jeromeverhoeven/firefly_jar/README.md

# 0xd
Define-Design-Develop-Destroy-Deploy

Structure of repository for product development

# Define:  The definition of the product
| Deliverable | Description | Owner |
|----|----|-----|
| [6080001](./Define/6080001.md)| MuSCoW |Jerome Verhoeven|

# Design: The design of the product
| Deliverable | Description | Owner |
|----|----|-----|
| [6080002](./Design/6080002.md) | Design Specification (Spec-2 Rev C) and House of Quality | Jerome Verhoeven|
| [6080003](./Design/6080003.md) | DD-1: Triggering Mechanism(s) | Jerome Verhoeven|
| [6080004](./Design/6080004.md) | DD-2: Electronics Platform | Jerome Verhoeven|
| [6080005](./Design/6080005.md) | DD-3: Power Source | Jerome Verhoeven|
| [6080006](./Design/6080006.md) | DD-4: LED Type and Count | Jerome Verhoeven|
| [6080007](./Design/6080007.md) | DD-5: Glow-Cycle Timing | Jerome Verhoeven|
| [6080008](./Design/6080008.md) | DD-6: Lid Venting | Jerome Verhoeven|
| [6080009](./Design/6080009.md) | DD-7: LED Mounting and Electronics Location | Jerome Verhoeven|
| [6080010](./Design/6080010.md) | DD-8: LED Color | Jerome Verhoeven|
| [6080011](./Design/6080011.md) | DD-9: Glow Pattern and Modes | Jerome Verhoeven|
| [6080012](./Design/6080012.md) | DD-10: Enclosure | Jerome Verhoeven|
| [Design Specification Template](./Design/Spec-1.md) | Template | TBD|
| [Design Decision Template](./Design/decision-template.md) | Template | TBD|

# Develop: The development of the product
| Deliverable | Description | Owner |
|----|----|----|
| [6080013](./Develop/6080013.md) | Bill of Materials | Jerome Verhoeven|
| [6080014](./Develop/6080014.md) | Flash Pattern Simulator ("Big Dipper Dialogue") | Jerome Verhoeven|
| [6080015](./Develop/6080015.md) | Dev Note: Courtship Sequence (male J-flash, female answer) | Jerome Verhoeven|
| [6080016](./Develop/6080016.md) | Prototype Assembly Drawings | Jerome Verhoeven|
| [6080017](./Develop/6080017.md) | Prototype Test Firmware | Jerome Verhoeven|
| [Asset Template](./Develop/asset-template.md) | Template | TBD|
| [Sample Asset](./Develop/sample1.md) | Template | TBD|

# Destroy: Testing
## Test Cases: Test Procedures
|Deliverable | Owner |
|----|----|
| [TC-EXAMPLE](./Destroy/TestCases/TC-EXAMPLE.md) | TBD |

## TestCycle-1
|[TC-EXAMPLE-EXE](./Destroy/TestCycle-1/TC-EXAMPLE-EXE.md) | Result |

# Deploy
| Deliverable | Description | Owner |
|---|---|---|
| [Asset Template](./Deploy/asset-template.md) | Description of Asset | TBD |

# Appendix
| File | Description | Owner |
|---|---|---|
| [Datasheets](./Appendix/Datasheets/README.md) | Manufacturer datasheets for BOM electronic parts | Jerome Verhoeven |
| [Asset Template](./Appendix/asset-template.md) | Description of Asset | TBD |
