jeromeverhoeven/firefly_jar/Design/6080002.md

# Asset: 6080002

## Description
Design specification for the Firefly Jar: renderings, functional and non-functional requirements traced to MuSCoW, architecture, pin map, behavior state machine, bill of materials and cost assessment, firmware configuration, assembly procedure, test plan, deployment schedule, rollback plan, and the House of Quality. Each design decision is its own asset (6080003-6080012).

## Revision
- A: initial working version
- B: all open design decisions resolved; House of Quality added; cost and operating principle updated
- C: specification restructured to the Spec-1 template; renderings redrawn for the top-hung lid layout; lid disc layout drawing, pin map, firmware parameters, assembly steps, test plan, and schedule added

## Content
 - [Design Specification](./Spec-2.md)
 - [House of Quality](./House-of-Quality.md)
 - [Exterior rendering](./Spec-2-media/rendering-exterior.svg)
 - [Internal section rendering](./Spec-2-media/rendering-internal-section.svg)
 - [Lid disc layout](./Spec-2-media/lid-disc-layout.svg)
 - Design decision assets: [6080003](./6080003.md), [6080004](./6080004.md), [6080005](./6080005.md), [6080006](./6080006.md), [6080007](./6080007.md), [6080008](./6080008.md), [6080009](./6080009.md), [6080010](./6080010.md), [6080011](./6080011.md), [6080012](./6080012.md)
