jeromeverhoeven/firefly_jar/Design/6080003.md

# Asset: 6080003

## Description
DD-1: Triggering Mechanism(s). Design decision selecting the wake/trigger sensors and how they combine: LDR (dusk) OR accelerometer (tap/shake/tilt) on the XIAO Sense, with the microphone as an opt-in clap mode. Includes standby-current analysis and the forced-rank options table.

## Revision
- A: initial decision (tilt/vibration switch + LDR, OR'd, ATtiny platform)
- B: re-evaluated against MuSCoW items 14-24 and DD-2 platform; accelerometer replaces tilt switch; sleep-current risk added

## Content
 - [DD-1: Triggering Mechanism(s)](./DD-1-Trigger-Mechanism.md)
