jeromeverhoeven/firefly_jar/Design/6080004.md

# Asset: 6080004

## Description
DD-2: Electronics Platform. Design decision selecting the MCU/board: Seeed XIAO nRF52840 Sense, chosen over ATtiny85 discrete builds, plain XIAO, and QT Py + BFF. Covers cost against the item 3 rule, build time, charging, reprogramming (item 22), and spare I/O.

## Revision
- A: initial working version

## Content
 - [DD-2: Electronics Platform](./DD-2-Platform.md)
