jeromeverhoeven/firefly_jar/Design/6080005.md

# Asset: 6080005

## Description
DD-3: Power Source. Design decision selecting a 500 mAh protected LiPo charged through the XIAO's USB-C charger. Contains the reference use profile and battery model used by every design decision's battery-life column.

## Revision
- A: initial working version

## Content
 - [DD-3: Power Source](./DD-3-Power-Source.md)
