jeromeverhoeven/firefly_jar/Design/6080006.md

# Asset: 6080006

## Description
DD-4: LED Type and Count. Design decision selecting 6 pre-wired 0603 3 V LEDs per jar (swarm density, joints, pins, battery impact).

## Revision
- A: initial working version

## Content
 - [DD-4: LED Type and Count](./DD-4-LED-Type-and-Count.md)
