jeromeverhoeven/firefly_jar/Design/6080007.md

# Asset: 6080007

## Description
DD-5: Glow-Cycle Timing and Wake Behavior. Design decision defining the night-light and toy timing: 30-minute night show with settle-down and re-arm rule; 60 s toy shows stackable to 5 minutes. Includes the behavior state machine.

## Revision
- A: initial working version

## Content
 - [DD-5: Glow-Cycle Timing and Wake Behavior](./DD-5-Glow-Cycle.md)
