jeromeverhoeven/firefly_jar/Design/6080008.md

# Asset: 6080008

## Description
DD-6: Lid Venting. Design decision for lid venting: 5-7 small "air holes" in the lid disc and dry preserved moss only (heat, condensation, mic, and thematic analysis).

## Revision
- A: initial working version

## Content
 - [DD-6: Lid Venting](./DD-6-Lid-Vent.md)
