jeromeverhoeven/firefly_jar/Design/6080009.md

# Asset: 6080009

## Description
DD-7: LED Mounting and Electronics Location. Design decision moving all electronics to a custom lid disc with the USB-C port facing up and LEDs hanging on loop-through anchors (top-hung vs. bottom-up).

## Revision
- A: initial working version

## Content
 - [DD-7: LED Mounting and Electronics Location](./DD-7-LED-Stem-Mounting.md)
