jeromeverhoeven/firefly_jar/Design/6080010.md

# Asset: 6080010

## Description
DD-8: LED Color. Design decision selecting yellow pre-wired LEDs as the standard firefly color, with warm white optional per cousin.

## Revision
- A: initial working version

## Content
 - [DD-8: LED Color](./DD-8-LED-Color.md)
