jeromeverhoeven/firefly_jar/Design/6080011.md

# Asset: 6080011

## Description
DD-9: Glow Pattern and Modes. Design decision for the animation: firefly-cadence fades with call-and-response, double-tap modes (Meadow → Sync → Clap), settle-down, low-battery, and tilt cues, with tiered firmware scope.

## Revision
- A: initial working version

## Content
 - [DD-9: Glow Pattern and Modes](./DD-9-Glow-Pattern.md)
