jeromeverhoeven/firefly_jar/Design/6080012.md

# Asset: 6080012

## Description
DD-10: Enclosure. Design decision for the jar: shatter-resistant PET for cousins 12 and under, glass for 13-16, sharing one lid design.

## Revision
- A: initial working version

## Content
 - [DD-10: Enclosure](./DD-10-Enclosure.md)
