jeromeverhoeven/firefly_jar/Develop/6080016.md

# Asset: 6080016

## Description
Prototype assembly drawings: a new wiring diagram (XIAO pins to LEDs, LDR divider, and battery — the one visual the project didn't have yet, since the pin map was table-only), plus a prototype-specific build checklist layered on top of [Spec-2's text assembly procedure](../Design/Spec-2.md#assembly-procedure-per-jar) and the existing [lid disc layout](../Design/Spec-2-media/lid-disc-layout.svg). Documents and resolves the as-purchased LED's built-in resistor (differs from [DD-4](../Design/DD-4-LED-Type-and-Count.md)'s bare-LED spec, flagged in the [2026-10-10 meeting](./Meetings/2026-10-10-Prototype-Parts-Order.md)).

## Revision
- A: initial build — wiring diagram, built-in-resistor resolution, prototype build checklist.
- B: corrected battery pads from assumed BAT+/BAT− to the actual silkscreened VIN/GND (found by inspecting the physical board); confirmed via the Seeed schematic that the USB-C shell shares the same GND net; added the ground-bus hand-soldering technique and the XIAO "on edge" mounting technique.

## Content
- [Assembly drawings and build checklist](./Assembly.md)
- [Wiring diagram](./Assembly-media/wiring-diagram.svg)
