jeromeverhoeven/firefly_jar/Develop/6080013.md

# Asset: 6080013

## Description
Bill of Materials for the Firefly Jar: every part needed to build one unit, with vendor, manufacturer, part numbers, and cost at qty 1 and qty 10, traced to the [Design Specification](../Design/Spec-2.md) and its design decisions (DD-1 through DD-10). Manufacturer datasheets for the electronic parts are collected in [Appendix/Datasheets](../Appendix/Datasheets/).

## Revision
- A: initial BOM, Develop-phase sourcing pass
- B: U1 vendor corrected from Seeed direct to Mouser, per the [2026-10-10 dev meeting](./Meetings/2026-10-10-Prototype-Parts-Order.md) — Seeed's own store was out of stock (per [DD-2](../Design/DD-2-Platform.md)), Mouser is the stock-driven choice DD-2 actually recommends

## Content
- [Bill of Materials](./BOM.md)
