jeromeverhoeven/firefly_jar/Develop/sample1.md

# Asset: sample1

## Description
A company called digikey

## Revision
unknown

## Content
- [www.digikey.com](http://www.digikey.com)
