jeromeverhoeven/firefly_jar/Design/Spec-1.md

# Design Specification

## Project Overview
Provide a brief overview of the project, including its purpose, goals, and objectives.
Just a generic link to an image generic

## Requirements
### Functional Requirements
List and describe the functional requirements of the project.

### Non-Functional Requirements
List and describe the non-functional requirements of the project.

## Design
### Architecture
Describe the overall architecture of the project, including diagrams if necessary.

```mermaid
classDiagram
        Animal <|-- Duck
        Animal <|-- Fish
        Animal <|-- Zebra
        Animal : +int age
        Animal : +String gender
        Animal: +isMammal()
        Animal: +mate()
        class Duck {
          +String beakColor
          +swim()
          +quack()
        }
        class Fish {
          -int sizeInFeet
          -canEat()
        }
        class Zebra {
          +bool is_wild
          +run()
        }
```

### Flow Chart Template
```mermaid
flowchart TD
        A(["Start"])
        A --> B{"Decision"}
        B --> C["Option A"]
        B --> D["Option B"]
```
### Sequence Diagram Template
```mermaid
sequenceDiagram
        actor Alice
        actor Bob
        Alice->>Bob: Hi Bob
        Bob->>Alice: Hi Alice
```

### Components
List and describe the main components of the project.

### Data Model
Provide a data model for the project, including diagrams if necessary.

## Implementation
### Technologies
List and describe the technologies that will be used in the project.

### Tools
List and describe the tools that will be used in the project.

## Testing
### Test Plan
Describe the test plan for the project, including the types of tests that will be performed.

### Test Cases
List and describe the test cases for the project.

## Deployment
### Deployment Plan
Describe the deployment plan for the project, including the environments and steps required.

### Rollback Plan
Describe the rollback plan in case of deployment failure.

## Maintenance
### Monitoring
Describe how the project will be monitored after deployment.

### Updates
Describe the process for updating the project after deployment.

## Appendix
Include any additional information or references here.
