jeromeverhoeven/firefly_jar/Develop/BOM.md

# Bill of Materials — Firefly Jar

**Asset:** [6080013](./6080013.md) · Traces to [Spec-2 Components](../Design/Spec-2.md#components) and the [Design Decisions](../Design/Spec-2.md#design-decisions) (DD-1 through DD-10). Datasheets for the electronic parts are in [Appendix/Datasheets](../Appendix/Datasheets/).

Qty is per jar unless marked "shared" (a consumable or bulk pack split across all 12 units). Cost columns are the vendor's own per-unit price at that purchase quantity, not an allocation of a shared pack — see **Sourcing notes** below for how bulk-only items (LEDs, jars, sheet goods) translate into a per-jar cost.

| # | Ref | Qty | Description | Vendor | Vendor P/N | Manufacturer | Mfr P/N | Cost @ Qty 1 | Cost @ Qty 10 | Link to Item |
|---|---|---|---|---|---|---|---|---|---|---|
| 1 | U1 | 1 | MCU module: nRF52840 (Cortex-M4F), onboard LSM6DS3TR-C 6-axis IMU, PDM mic, BQ25101 LiPo charger, USB-C | Mouser | [713-102010469](https://www.mouser.com/ProductDetail/Seeed-Studio/102010469) | Seeed Studio | 102010469 | $15.90 | not confirmed — check live Mouser price-break table before ordering | [Mouser](https://www.mouser.com/ProductDetail/Seeed-Studio/102010469) |
| 2 | BT1 | 1 | LiPo battery, 3.7 V 500 mAh, protected, pre-attached JST-PH connector | Adafruit | [1578](https://www.adafruit.com/product/1578) | Adafruit (cell form factor LP503035) | LP503035 | $7.95 | $7.16 (10+) | [Adafruit #1578](https://www.adafruit.com/product/1578) |
| 3 | J1 | 1 | JST-PH 2-pin cable, male header, 200 mm leads (pigtail soldered to XIAO BAT pads) | Adafruit | [3814](https://www.adafruit.com/product/3814) | Adafruit | 3814 | $0.75 | $0.68 (10-99) | [Adafruit #3814](https://www.adafruit.com/product/3814) |
| 4 | LDR1 | 1 | CdS photoresistor (LDR), GL5528-class, 5 mm | Adafruit | [161](https://www.adafruit.com/product/161) | Generic (GL5528) | GL5528 | $0.95 | $0.95 (flat) | [Adafruit #161](https://www.adafruit.com/product/161) |
| 5 | R7 | 1 | 100 kΩ 1/4 W carbon-film resistor, LDR pull-down divider | DigiKey | [CFR-25JB-52-100K](https://www.digikey.com/en/products/detail/yageo/CFR-25JB-52-100K/245) | YAGEO | CFR-25JB-52-100K | ~$0.10 (est.) | $0.034 (10+) | [DigiKey](https://www.digikey.com/en/products/detail/yageo/CFR-25JB-52-100K/245) |
| 6 | R1-R6 | 6 | 1 kΩ 1/4 W carbon-film resistor, LED series resistor on D2-D7 | DigiKey | [CFR-25JB-52-1K](https://www.digikey.com/en/products/detail/yageo/CFR-25JB-52-1K/96) | YAGEO | CFR-25JB-52-1K | ~$0.10 (est.) ea. | ~$0.034 (est., 10+) ea. | [DigiKey](https://www.digikey.com/en/products/detail/yageo/CFR-25JB-52-1K/96) |
| 7 | D1-D6 | 6 | Pre-wired 0603 SMD LED, yellow, 3 V (no onboard resistor), 30 cm leads | eBay (listing 227363613241) | — (no catalog P/N; seller listing only) | Unbranded / generic OEM | — | n/a — bulk only | $29.99 per 100-pack + ~$3 ship (≈$0.33/LED) | [eBay listing](https://www.ebay.com/itm/227363613241) |
| 8 | — | 1 (PET-assigned jars) | 16 oz clear PET plastic mason-style jar w/ lid, regular-mouth thread (**verify band fit before bulk order**, per [DD-10](../Design/DD-10-Enclosure.md)) | Amazon | [B07WVRF2XV](https://www.amazon.com/Clear-Plastic-Labels-Kitchen-ZMYBCPACK/dp/B07WVRF2XV) | ZMYBCPACK | — | n/a — 12-pack only | ≈$2.25/jar (12-pack; est., see note) | [Amazon listing](https://www.amazon.com/Clear-Plastic-Labels-Kitchen-ZMYBCPACK/dp/B07WVRF2XV) |
| 9 | — | 1 (glass-assigned jars) | 16 oz Ball regular-mouth glass pint mason jar w/ lid & band | HEB | [30016](https://www.heb.com/product-detail/ball-regular-mouth-12-pk-pint-mason-jars-lids/30016) | Ball (Newell Brands) | 14400-61000 | n/a — 12-pack only | $1.12/jar (12-pack, $13.44 total) | [HEB listing](https://www.heb.com/product-detail/ball-regular-mouth-12-pk-pint-mason-jars-lids/30016) |
| 10 | — | ~1/12 sheet | 3 mm Baltic birch plywood, 12x12 in, cut to the jar's lid-insert diameter for the custom disc ([DD-7](../Design/DD-7-LED-Stem-Mounting.md)) | Amazon | [B07H3CGLQ8](https://www.amazon.com/Artlicious-3mm-Baltic-Plywood-Sheets/dp/B07H3CGLQ8) | Artlicious | — | n/a — 20-pack only | $1.70/sheet (20-pack, $33.99 total) | [Amazon listing](https://www.amazon.com/Artlicious-3mm-Baltic-Plywood-Sheets/dp/B07H3CGLQ8) |
| 11 | — | 1 sheet | Translucent/frosted vellum sheet, 12x12 in, jar liner for a consistent diffused glow ([DD-10](../Design/DD-10-Enclosure.md)) | Amazon | [B08BNR9WG9](https://www.amazon.com/Translucent-Vellum-Paper-Sheets-Invitations/dp/B08BNR9WG9) | Generic/craft | — | n/a — 100-pack only | $0.23/sheet (100-pack, $22.99 total) | [Amazon listing](https://www.amazon.com/Translucent-Vellum-Paper-Sheets-Invitations/dp/B08BNR9WG9) |
| 12 | — | shared (1 bag / 12 units) | Preserved (dry) reindeer moss, base dressing — dry only, no live moss ([DD-6](../Design/DD-6-Lid-Vent.md)) | Amazon | [B07QSD64QB](https://www.amazon.com/Preserved-Reindeer-Moss-oz-Spanish/dp/B07QSD64QB) | Generic/SuperMoss-style | — | $6.99 (2 oz bag, shared) | n/a — single bag covers all 12 | [Amazon listing](https://www.amazon.com/Preserved-Reindeer-Moss-oz-Spanish/dp/B07QSD64QB) |
| 13 | — | shared | Mini hot-glue sticks, 4 in x 0.27 in, clear all-temp — LED anchor strain relief, moss/liner mounting | Amazon | [B003JZII34](https://www.amazon.com/Surebonder-DT-100-Sticks-All-Temperature-5-Sticks-100/dp/B003JZII34) | Surebonder | DT-100 | $5.67 (100-pack, shared) | n/a — single pack covers all 12 | [Amazon listing](https://www.amazon.com/Surebonder-DT-100-Sticks-All-Temperature-5-Sticks-100/dp/B003JZII34) |
| 14 | — | shared | 22 AWG stranded silicone hookup wire, 6-color kit — BAT pigtail extension, anchor-loop leads | Amazon | [B01LH1FR6M](https://www.amazon.com/StrivedayTMFlexible-Silicone-Electric-electronic-electrics/dp/B01LH1FR6M) | Striveday | — | $14.99 (kit, shared) | n/a — single kit covers all 12 | [Amazon listing](https://www.amazon.com/StrivedayTMFlexible-Silicone-Electric-electronic-electrics/dp/B01LH1FR6M) |
| 15 | — | optional, 1/gift | USB-C charging cable — **optional add-on, not required** (most households already own one); excluded from the unit-cost total per [Spec-2 Cost Feasibility](../Design/Spec-2.md#cost-feasibility) | Amazon (generic) | — | Generic | — | ~$6-8 (est., per cable) | n/a | — |

## Sourcing notes
- **U1 vendor corrected to Mouser (2026-10-10 dev meeting).** Seeed's own store was out of stock as of Oct 9, 2026 per [DD-2](../Design/DD-2-Platform.md)'s own Availability research; Mouser (713-102010469, ~391 in stock at the time of DD-2) is the stock-driven choice DD-2 actually recommends, so the BOM now matches it instead of citing Seeed direct for cleaner qty-10 pricing. Mouser's qty-10 price break wasn't independently confirmed in this pass — check the live pricing table before ordering.
- **LEDs, jars, and sheet goods are bulk-only.** The eBay LED listing, both jar vendors, the plywood, and the vellum are sold only in fixed packs (100, 12, 12, 20, and 100 respectively) — there is no distributor "qty 1" or "qty 10" price break to quote, so the Cost columns show the pack price and the effective per-item cost it works out to.
- **R7 and R1-R6 pricing is an estimate** (marked "est."): DigiKey's own qty-10 break for this exact YAGEO CFR-25 value wasn't confirmed by automated search in this pass — confirm the live price on the DigiKey product pages linked above before ordering.
- **PET jar vendor is a substitute**, not the one named in [DD-10](../Design/DD-10-Enclosure.md) — the Cornucopia 16 oz 8-pack DD-10 names was out of stock as of Oct 9, 2026. This ZMYBCPACK 12-pack is a same-category replacement found during this BOM pass. **Per DD-10's own open item, test-fit one jar's thread against the regular-mouth lid disc/band before ordering the rest.**
- **Jar split:** DD-10 assumes a 6/6 PET-vs-glass split pending the actual cousin age count — order rows 8 and 9 in that ratio until the age split (an [open item](../Design/Spec-2.md#open-items) in Spec-2) is confirmed.
- **Shared consumables** (moss, glue, wire kit, and the fractional plywood/vellum sheets) are bought once and divided across all 12 units by hand during assembly — their Qty column says "shared" rather than a per-jar count.
- **Spares:** order the 100-pack of LEDs even though only 72 are needed (6 x 12) — this already includes 28 spares per [DD-4](../Design/DD-4-LED-Type-and-Count.md). No other line needs a separate spares order at this batch size.

## Per-jar cost rollup (qty-1 columns, electronics only)
U1 + BT1 + J1 + LDR1 + R7 + 6xR1-R6 + 6xD1-D6 = $15.90 + $7.95 + $0.75 + $0.95 + $0.10 + $0.60 + $1.98 ≈ **$24.23/unit** in electronics, close to the [Spec-2](../Design/Spec-2.md#cost-feasibility) Rev C estimate of ~$29.99/unit once the jar, lid disc, liner, and dressing (rows 8-13) are added. Small differences from Spec-2's figures reflect this pass's actual vendor sourcing (e.g., Seeed direct vs. Mouser, and a substitute PET jar vendor) rather than a design change.
