jeromeverhoeven/firefly_jar/Destroy/TestCases/TC-PCBA-BOM-COMP-SUB.md

## Test ID:
TC-PCBA-BOM-COMP-SUB

## Test Name:
PCBA BOM Component Substitution — General Procedure

## Test Description:
Verify that a proposed substitute component is acceptable for use on the PCBA by validating electrical, mechanical, and procurement attributes, performing assembly/prototype verification, and executing basic functional and thermal tests.

## Scope:
Applies to one proposed substitute component on the PCBA BOM. This is a general procedure; specific test limits and measurements depend on the component type and circuit function.

## Preconditions:
- Original BOM and proposed substitute BOM entry available.
- Datasheets for original and substitute components.
- Board layout / footprint drawings.
- One or more sample substitute components available.
- Rework station or assembly capability to populate at least one board.

## Result:
- Result of the test execution

## Test Steps:
| Step Number | Description | Test Data / Artifacts | Expected Results / Pass Criteria | Link | Actual Results | Notes |
|---|---|---|---|---|---|---|
| 1 | Review BOM and part history | BOM, ECOs, procurement records | Identify original part number and proposed substitute | [BOM](#) | | Confirm revision levels |
| 2 | Compare datasheets: electrical specs | Datasheets (original + substitute) | Key parameters (voltage, current, tolerance, ESR, etc.) are equal or within acceptable delta | [DS](#) | | Document any differences |
| 3 | Verify mechanical/footprint and pinout compatibility | Footprint drawings, 3D models | Substitute fits footprint; pin mapping matches | [Footprint](#) | | Note adapter or landing changes |
| 4 | Check reliability / environmental ratings | Datasheets, reliability reports | Temperature, moisture, shock ratings meet requirements  | [Env](#) | | |
| 5 | Confirm procurement, lead-time, cost, and manufacturer qualification | Supplier quotes, MOQ, QPL/approval status | Supplier viable; cost/lead-time acceptable | [PO](#) | | |
| 6 | Create or update BOM entry and cross-reference (internal part numbers) | Updated BOM, change record | BOM updated with justification and traceability | [BOM-Change](#) | | Include approval fields |
| 7 | Populate prototype or perform controlled rework on one or more boards | Reworked board(s), assembly report | Component correctly soldered with no mechanical issues  | [Assembly](#) | | Use same process as production |
| 8 | Visual inspection and microscopy | Inspection report, photos | No solder bridges, tombstoning, or misalignment | [Inspect](#) | | |
| 9 | Basic electrical checks (continuity, shorts, passive measurements) | DMM, LCR meter | No shorts; expected passive values within tolerance | [Elec](#) | | Test critical nets |
| 10 | Power-up with current limit and smoke test | Bench PSU, current limit | Board powers without overcurrent or smoke | [Power](#) | | Monitor temperature |
| 11 | Functional verification of affected circuit blocks | Functional test vectors, test jig | Circuit meets functional requirements | [Func](#) | | Run regression tests |
| 12 | Thermal and stress check under expected load | Thermal camera, temperature sensors | Temperatures within allowed range, no degradation | [Thermal](#) | | Duration per spec |
| 13 | Record results, attach evidence, and obtain engineering sign-off | Test reports, photos, datasheet comparison | Formal approval or rejection with defined remediation | [Report](#) | | Include recommended actions  |
| 14 | If approved, publish BOM revision and notify manufacturing | Approved ECO, updated BOM | Production BOM updated; supplier notified | [ECO](#) | | Close change loop |
