jeromeverhoeven/firefly_jar/Destroy/TestCases/TC-EXAMPLE.md

## Test ID:
TC-EXAMPLE

## Test Name:
Example Test Case

## Test Description:
Example Description

## Test Steps:
| Step Number | Description | Test Data | Expected Results | Link |
|---|---|---|---|---|
| 1 | Description of step 1  | Test data 1 | Expected result for step 1 | [Link 1](#) |
| 2 | Description of step 2  | Test data 2 | Expected result for step 2 | [Link 2](#) |
| 3 | Description of step 3  | Test data 3 | Expected result for step 3 | [Link 3](#) |
