jeromeverhoeven/firefly_jar/Destroy/TestCycle-1/TC-EXAMPLE-EXE.md

## Test ID:
TC-EXAMPLE

## Test Name:
Example Test Case

## Test Description:
Example Description

## Result:
- Result of the test execution
## Test Steps:
| Step Number | Description | Test Data | Expected Results | Link | Actual Results | Pass / Fail | Results Link | Notes |
|---|---|---|---|---|---|---|---|---|
| 1 | Description of step 1  | Test data 1 | Expected result for step 1 | [Link 1](#) | Actual result for step 1 | | [Results Link 1](#) | Notes for step 1 |
| 2 | Description of step 2  | Test data 2 | Expected result for step 2 | [Link 2](#) | Actual result for step 2 | | [Results Link 2](#) | Notes for step 2 |
| 3 | Description of step 3  | Test data 3 | Expected result for step 3 | [Link 3](#) | Actual result for step 3 | | [Results Link 3](#) | Notes for step 3 |
