jeromeverhoeven/firefly_jar/(commit log)

2026-10-09 Define MuSCoW requirements and add initial Firefly Jar design spec
    Populates the MuSCoW with firefly-jar-specific requirements (look,
    battery power, cost target, shake/light/sound trigger options, trigger
    combination logic, and a joy-of-use requirement), and adds the first
    Design asset (6080002) with concept renderings, operating principle,
    and cost feasibility analysis.
2026-10-10 Add flexible-platform requirement; reopen activation method as a design decision
    Adds MuSCoW item 12 (flexible power/animation platform for other
    small jar items) and reframes Spec-2's tilt+LDR/OR sensor choice as a
    leading candidate rather than a locked decision, with the
    activation-method choice itself promoted to an explicit open design
    decision alongside the LED stem-mounting one.
2026-10-10 Expand to full design package: revised MuSCoW, DD-1 through DD-10, House of Quality, Spec-2 Rev C
    MuSCoW updated for the 12-cousins/Christmas-2026 scope (24 items,
    qty-12 budget framing, safety/durability/schedule requirements).
    Design folder now carries ten resolved design decisions (trigger
    mechanism, platform, power source, LED type/count, glow-cycle timing,
    lid venting, LED mounting/electronics location, LED color, glow
    pattern/modes, enclosure), a House of Quality, and Spec-2 rewritten to
    Rev C with pin map, state machine, wake sequence, and build/test plan.
    New design decisions and the House of Quality are registered as
    assets 6080003-6080012.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
2026-10-10 Add Bill of Materials (asset 6080013) and component datasheets
    Develop/BOM.md lists every part needed to build one jar - MCU module,
    battery, connector, LDR, resistors, LEDs, both jar variants, lid disc,
    liner, moss, glue, wire, and an optional charging cable - with vendor,
    manufacturer, part numbers, qty-1/qty-10 pricing, and buy links,
    traced to Spec-2 and DD-1 through DD-10. Appendix/Datasheets collects
    the manufacturer datasheets for the electronic parts.
2026-10-10 Hold first dev meeting: prototype order, resistor review, BOM vendor fix
    Develop/Meetings/2026-10-10-Prototype-Parts-Order.md: agreed the
    prototype parts list, reviewed necessity/value of the LED series and
    LDR pull-down resistors against the Nordic and GL5528 datasheets, and
    caught a BOM/DD-2 mismatch (U1 listed Seeed direct, which DD-2 already
    found out of stock - switched to Mouser, matching DD-2's own call).
    Also logged a post-meeting update: parts were purchased via Amazon to
    consolidate shipping, including LEDs with a built-in 3V-rated resistor
    that differs from DD-4's spec - flagged for reconciliation next
    meeting rather than changed unilaterally.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
2026-10-10 Add flash pattern simulator for evaluating firefly courtship timing
    Develop/Tools/flash-dialogue-simulator.html ("Big Dipper Dialogue"):
    an interactive bench modeling Photinus pyralis courtship - the male's
    dip-and-hook J-flash, the female's timed answer, and the dark gaps
    between - with documented field ranges shown per parameter and a live
    export to the firmware constants named in Spec-2's Data Model
    (FLASH_PERIOD_S, FADE_MS, ANSWER_DELAY_MS). Registered as asset
    6080014 and cross-linked from DD-9, which these timing figures trace
    to.
2026-10-12 Add prototype assembly drawings and test firmware; reconcile courtship model
    Reconciled DevNote 6080015's LED hand-off courtship model against the
    flash-pattern simulator's conflicting approach (flagged as an open item
    in the dev note) - DD-9 and Spec-2's Data Model now point to the dev
    note's model as the one firmware follows.
    Develop/Assembly.md (6080016): a wiring diagram for the XIAO/LEDs/LDR/
    battery (the pin map was table-only before), resolving the purchased
    LEDs' built-in resistor against DD-4's bare-LED spec, plus a prototype
    build checklist.
    Develop/Firmware (6080017): a hardware bring-up sketch, and a Meadow +
    courtship demo implementing the dev note's sequence - found and fixed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
2026-10-13 Fix firmware build/upload bugs; add assembly technique notes; verified on real hardware
    Firmware fixes (both found and fixed during first real upload attempt,
    confirmed working on the actual board):
    - Replaced invented P0_14/P0_31 pin macros (didn't exist, failed to
    compile) with the board package's own VBAT_ENABLE/PIN_VBAT, verified
    against a working community library.
    - Caught a silent scaling bug: that library's VBAT constant assumes
    the ADC's default 10-bit resolution, but the sketch had switched to
    12-bit - would have read battery voltage ~4x too high. Removed the
    resolution override instead of guessing a correction factor.
    - Added the missing Adafruit_TinyUSB.h include both s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
